arnottrcaiado/mangue-interativo/preview/cena_v7.gif

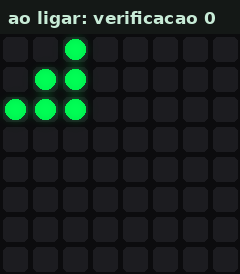
preview/cena_v7.gif
