arnottrcaiado/mangue-interativo/preview/olhar_avisos.png

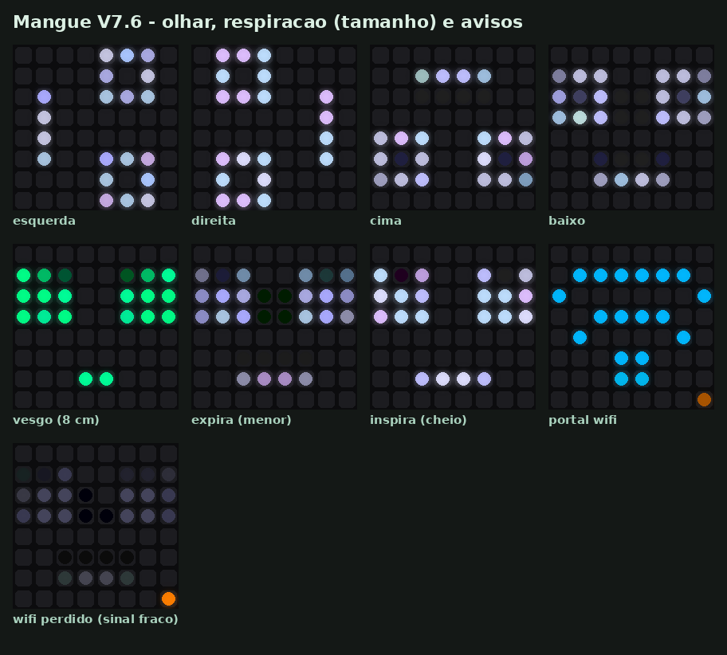
preview/olhar_avisos.png
