arnottrcaiado/mangue-interativo/preview/paletas.png

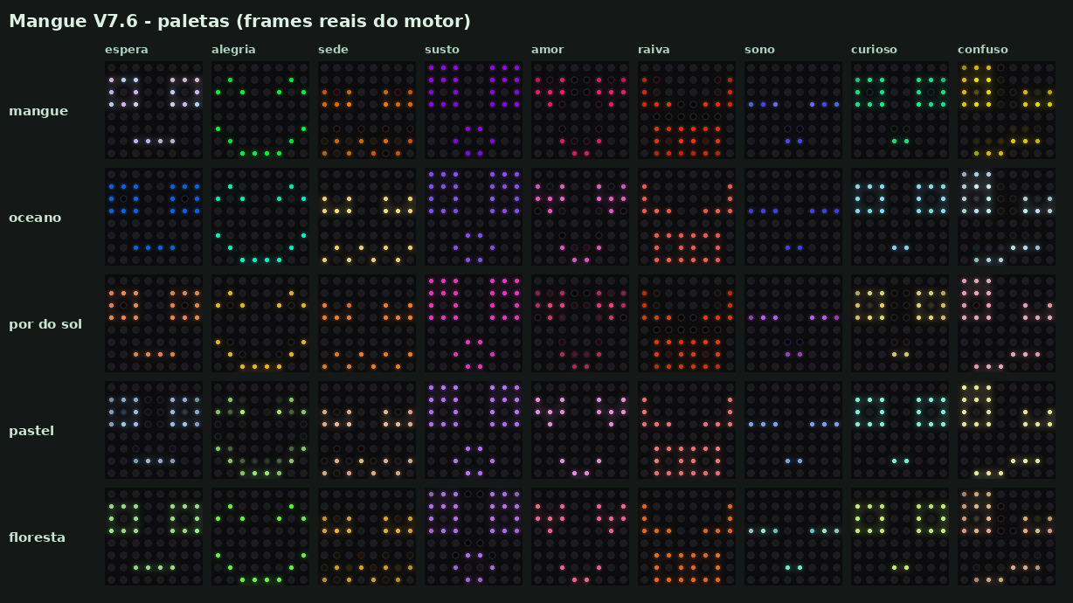
preview/paletas.png
