arnottrcaiado/mangue-interativo/preview/protetores.gif

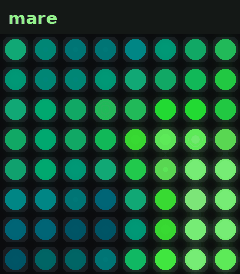
preview/protetores.gif
