arnottrcaiado/mangue-interativo/preview/protetores.png

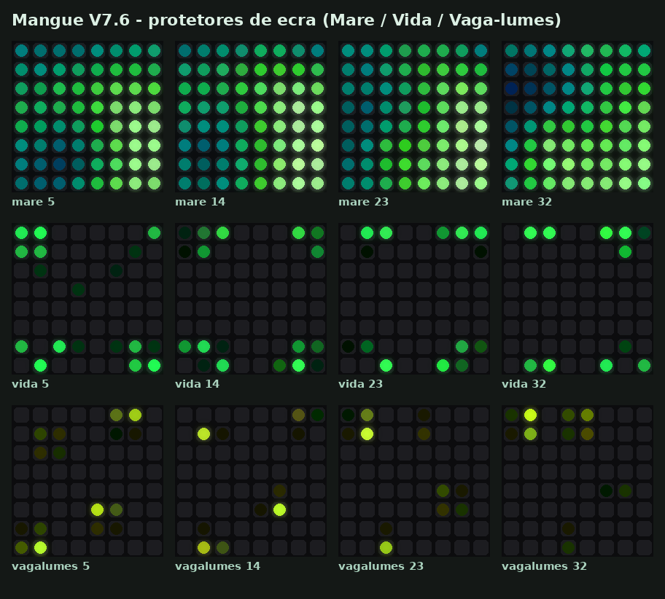
preview/protetores.png
