arnottrcaiado/mangue-interativo/preview/sinalizacao.png

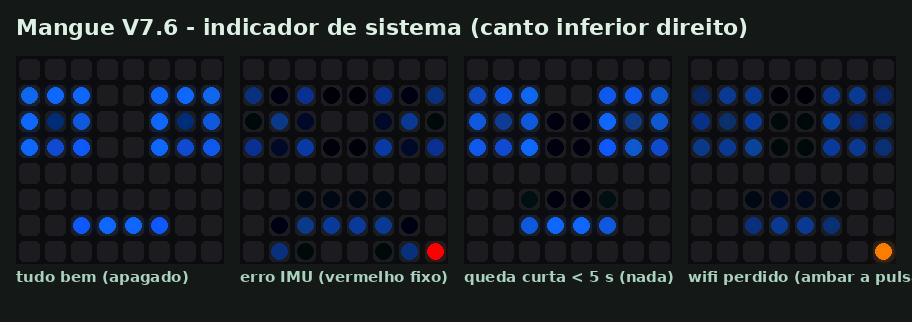
preview/sinalizacao.png
