arnottrcaiado/mangue-interativo/preview/web_cor_unica.png

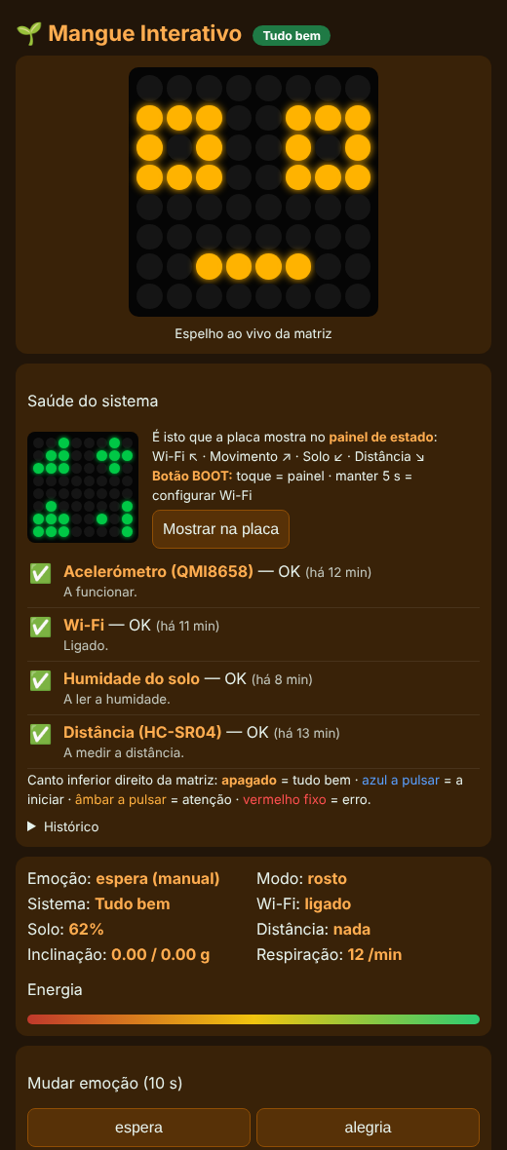
preview/web_cor_unica.png
