arnottrcaiado/mangue-interativo/preview/web_erro_solo.png

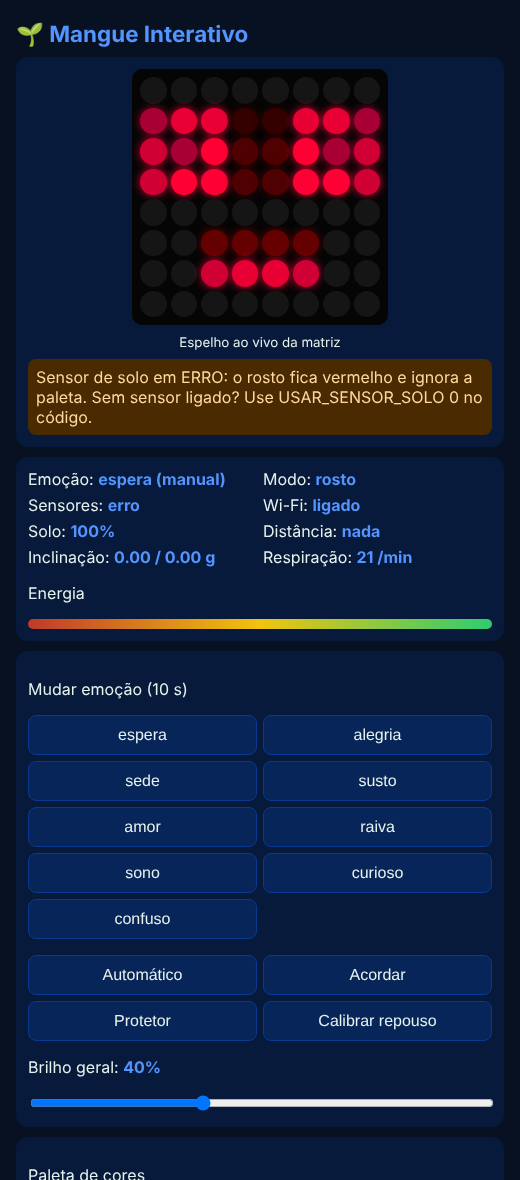
preview/web_erro_solo.png
