arnottrcaiado/mangue-interativo/preview/web_orientacao.png

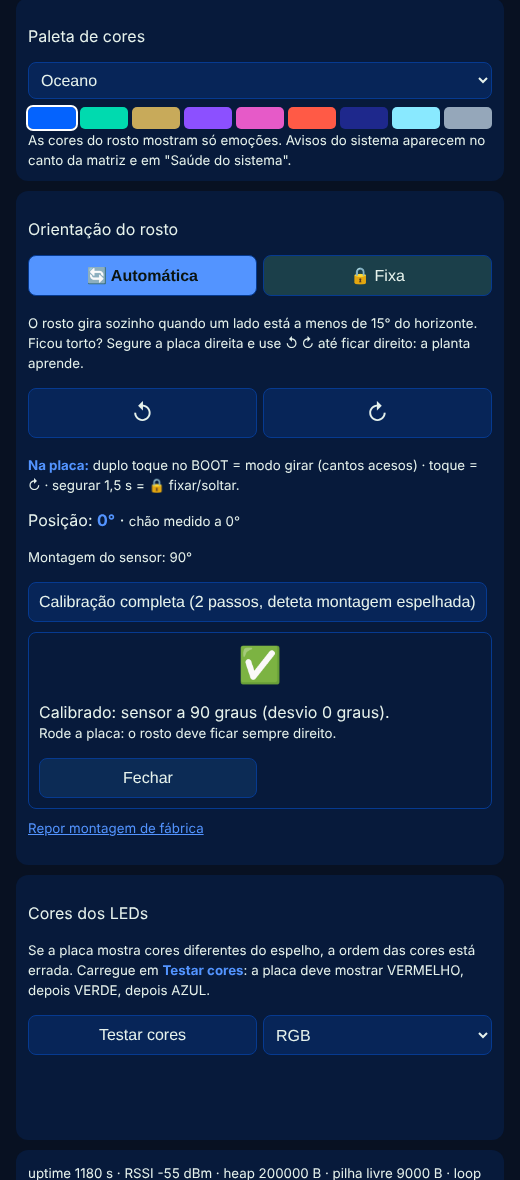
preview/web_orientacao.png
