arnottrcaiado/mangue-interativo/banco_de_testes/LEIA-ME.txt

Banco de testes no PC. Nao substitui testar na placa. Ver README.md, secao 11.
