arnottrcaiado/mangue-interativo/preview/web_calibrar_orientacao.png

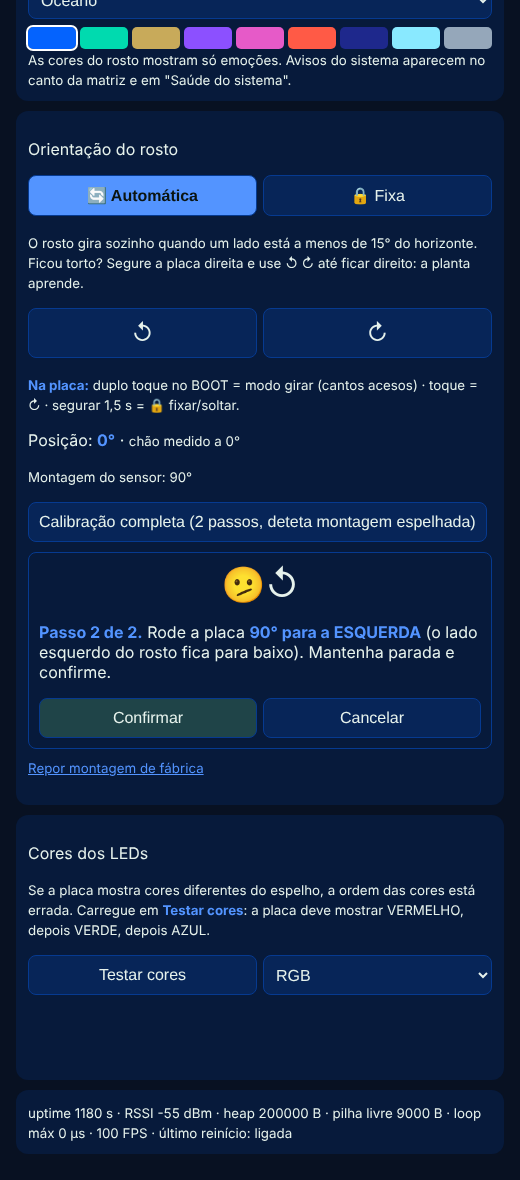
preview/web_calibrar_orientacao.png
