arnottrcaiado/mangue-interativo/preview/web_teste_cores.png

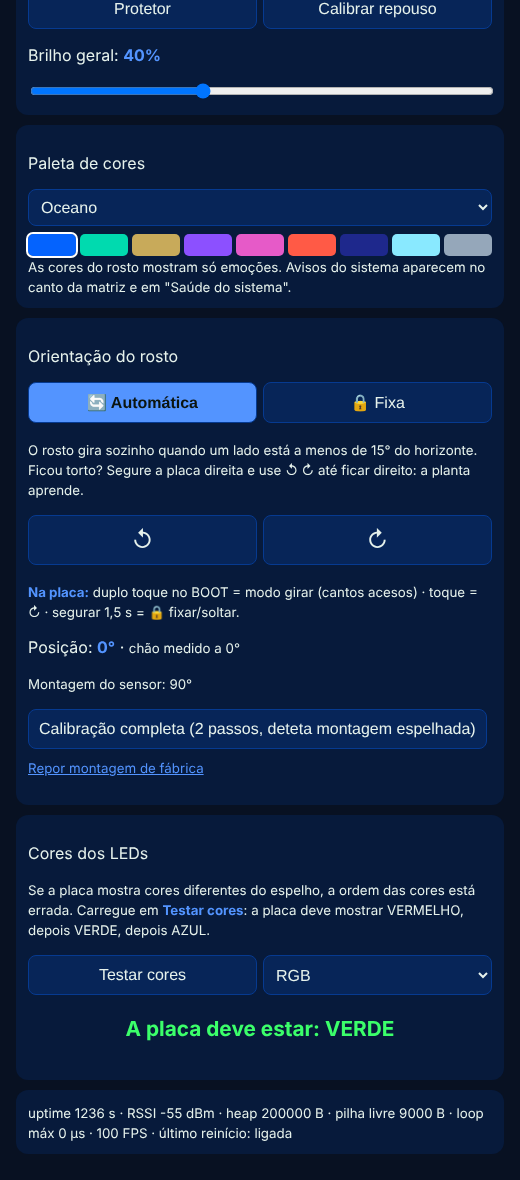
preview/web_teste_cores.png
